smokebad0307/amb82-person-height-estimation/README_量測精度與問題分析.md

# AMB82 身高量測：目前公式、精度限制與問題排查

更新日期：2026-10-15。供組員理解目前結果，以及規劃「相機 bbox＋超聲波測距」的下一輪實驗。

## 目前的判斷

**影像高度加上距離，在適當的相機幾何與量測條件下，可以估算身高。但目前四位受試者得到的公式，尚未達到未知人物身高誤差 ±2 cm 的目標。**

目前使用複核過的影像端點及照片標示距離，留一受試者驗證的身高 RMSE 已約 3.93 cm，最大絕對誤差約 9.66 cm。未來接上自動 bbox 與超聲波後，還需要驗證這兩個輸入帶來的額外誤差。

更換較好的測距模組可能改善波動，但不能自行消除「測距終點不同」、相機設定、人體姿勢或 bbox 邊界的偏差。**目前的 3.93 cm 也不是這種方法無法改善的理論下限。**

## 1. 我們要做的系統

目標流程：

1. AMB82 相機拍攝人物，取得全身 bbox。
2. 將 bbox 座標還原到校正使用的影像座標，計算像素高度 `h`。
3. 超聲波取得距離讀值，確認其量測基準並換算成公式需要的距離 `D`。
4. 將 `h` 與 `D` 代入公式，得到身高估計 `H_est`。
5. 使用未參與校正的人與拍攝批次，驗證整套系統是否達到 ±2 cm。

### 使用者已確認的條件

| 項目 | 目前條件 |
|---|---|
| 精度目標 | 身高誤差在 ±2 cm 以內 |
| 相機 | AMB82-mini；本次原圖為 1280×720 |
| 距離定義 | 鏡頭與人體中心各自垂直投影到地面後，兩個投影點之間的水平距離 |
| 拍攝條件 | 四組拍攝時，相機位置、俯仰角與影像設定「大致固定」；尚無精確固定程度的量測紀錄 |
| 超聲波 | 目前使用 HC-SR04，使用者反映效果不好，預計更換模組 |
| 身高基準 | 四位受試者的參考身高皆包含拍照時的鞋子 |

**本文件沒有 HC-SR04 的實測誤差紀錄，不能將現有身高偏差直接歸因於該模組。** 目前離線資料使用的是照片標示距離，尚未完成實際超聲波讀值與身高結果的整合驗證。

## 2. 距離與像素高度的定義

### 距離 D 是地面上的水平距離

以下為側面示意；C 與 P 的高度不必相同：

```text
鏡頭 C                    人體中心 P
     |                             |
     | 垂直投影                    | 垂直投影
     |                             |
地面 A --------------------------- B
                 水平距離 D
```

兩條投影線都垂直地面且互相平行，`D = A 到 B 的水平距離`。相機光軸與超聲波軸線是否水平，需要另外記錄，不能只由這個距離定義判定。

在相機光軸水平、人物站直、頭腳近似位於相同深度，且人物位於相機正前方的條件下，這個水平距離可近似作為成像模型所需的深度。若人偏向側方，地面兩點的直線距離與沿光軸的深度也要區分。

### 像素高度 h 的定義

- 校正使用原始 1280×720 影像。
- 端點為可辨識的頭髮頂端與最低鞋底，排除地面陰影。
- 本次標註座標從 0 起算，兩端像素都包含：`h = y_max - y_min + 1`。
- 若部署程式使用浮點座標或右下角不包含的 bbox，應依該格式計算並統一量測定義，不可直接混用 `+1`。
- 這是影像中的垂直跨度；髮型、站姿與鞋子都會影響它。

## 3. 目前公式與資料範圍

主要公式直接擬合每張照片的 `cm/px`：

```text
s(D) = 0.001374586854 × D + 0.022063368530
H_est = h × s(D)

D：水平距離，cm
h：影像全身高度，px
s：影像比例，cm/px
H_est：估計含鞋身高，cm
```

| 受試者 | 含鞋身高 | 照片數 | 納入統計 |
|---|---:|---:|---:|
| lai | 162 cm | 40 | 40 |
| yang | 170 cm | 45 | 45 |
| wang | 173 cm | 20 | 19 |
| huang | 188 cm | 41 | 41 |
| 合計 | — | 146 | 145 |

實測距離為 180、190、200、220、240、250、260、300 cm；190、250 cm 只有原 wang 資料。`173_wang/190_5.jpg` 因頭頂疑似裁切，保留可見高度但排除擬合。

目前沒有對其他身高範圍、任意場景或任意相機姿態的精度保證。每 1 cm 預測表是公式計算結果，不代表每個距離都拍過照片。

另有像素目標反比模型 `H_est = h × D / 676.873420513`，它與上面的主要公式使用不同擬合目標，不能混用係數。本文件的誤差敏感度與 ±2 cm 達成比例，均以主要直線公式為準。

## 4. 現有資料能支持多少精度

| 評估方式 | 身高誤差 | 代表的意義 |
|---|---:|---|
| 全資料擬合，再評估原資料 | RMSE 3.205 cm | 公式對已看過資料的擬合程度 |
| 留一距離驗證 | RMSE 3.341 cm | 保留一個距離，用其他距離擬合後預測 |
| 留一受試者驗證 | RMSE 3.925 cm | 保留一人的全部照片，用另外三人擬合後預測 |
| 留一受試者最大絕對誤差 | 9.656 cm | 本批驗證中最差的單張結果 |
| 留一受試者誤差在 ±2 cm 內 | 71／145 張，約 49.0% | 本批照片的達標比例 |

留一受試者更接近「遇到未知身高的人」的使用情境，但目前只有四位受試者，且人員與拍攝批次混雜。145 張照片不等於 145 位獨立受試者，49.0% 也不能當作未來部署的成功率。

**RMSE 是誤差大小的統計指標，不是最大誤差界限。** RMSE 3.925 cm 不代表每次都在 ±3.925 cm 內。

比例擬合的 R² 約為 0.988，仍不代表身高能準到 ±2 cm；距離變化造成的整體趨勢可以很明顯，同時保留數公分的系統偏差。

目前的擬合身高誤差與分組驗證

## 5. 可能造成大偏差的四個環節

### 5.1 超聲波量測終點與原公式不一致

原校正 `D` 的終點是人體中心的地面投影。超聲波的回波則可能來自胸口、腹部、衣服或其他可被偵測的表面，並不是人體中心。模組與鏡頭本身也可能有前後或左右的安裝偏移。

即使測距方向與地面平行，這個終點差異仍然存在：兩個讀值都可能很穩定，但有固定偏差。人體厚度、姿勢及衣服不同，偏差也可能改變，因此不能預設加一個固定常數就能解決所有人。

超聲波對回波的選擇依模組而異；例如 MaxBotix 的部分模組以首個足夠強的回波決定距離，常對應視野內較近的可偵測物體。這是需實測確認的測距行為，不能直接套成 HC-SR04 的實測規格。[廠商說明](https://maxbotix.com/blogs/blog/best-ultrasonic-sensor-indoor-mobile-robotics)

**要做的事：** 同時記錄已知水平距離、原始超聲波讀值、模組安裝位置及人體姿態，先確認兩個距離的關係。若改用超聲波原始讀值作為新模型輸入，必須重新校正，並驗證不同體型與新受試者。

### 5.2 現有資料已有批次差異

同樣標示 200 cm，各組平均像素高度除以各自參考身高後：

| 受試者 | 平均像素高度 | 參考身高 | 平均像素／身高 |
|---|---:|---:|---:|
| lai | 554.29 px | 162 cm | 3.422 px/cm |
| yang | 566.00 px | 170 cm | 3.329 px/cm |
| wang | 604.80 px | 173 cm | 3.496 px/cm |
| huang | 626.50 px | 188 cm | 3.332 px/cm |

wang 與 yang 的比例相差約 5%。同一人同距離的照片卻通常只有約 1–2 px 的波動，表示**重複量測穩定，不等於不同批次的絕對比例一致**。

可能原因包含距離基準、站位、相機角度、影像設定、姿勢或參考身高，現有資料不足以確定主因。合併直線只能折衷這些差異。

原 wang 批次在合併公式下平均高估約 6.32 cm；lai 的 180 cm 組也有較大負偏差。這些資料已保留，不能因為誤差大就直接刪除。增加高次項也尚未改善問題：二次式的留一受試者 RMSE 約 4.02 cm，直線約 3.93 cm。

**要做的事：** 在同一次固定架設下，讓四人輪流站到同一個精確位置，重新比較比例。每次離開再站回，才能觀察站位重現性；不要只用連拍代替獨立重站。

### 5.3 相機幾何及影像設定不完全相同

在理想、水平、已處理畸變的成像條件下，可近似寫成：

```text
h ≈ f_y × H / D
```

其中 `f_y` 是以像素為單位的垂直焦距。這說明方案理論上可行，但需要幾何條件成立；目前由資料擬合出的係數，不等於已完成相機內參標定。

相機俯仰時，頭頂與腳底在相機座標中的深度可能不同，影像比例會受相機姿態、人物身高及位置影響。鏡頭畸變、裁切、解析度與縮放也會改變對應關係。[OpenCV 相機投影與校正模型](https://docs.opencv.org/4.13.0/d9/d0c/group__calib3d.html)

**要做的事：** 固定支架、相機位置、俯仰與滾轉角，記錄相機高度與影像設定。需要時使用標定板取得內參與畸變參數。推論圖若經 resize 或 letterbox，必須先將 bbox 正確還原到校正座標。

### 5.4 自動 bbox 與目前複核端點的定義不同

目前資料是逐張檢視後的頭腳端點，不是部署中的自動人體偵測器輸出，也不是獨立人工真值驗證。偵測器可能框得較鬆、漏掉髮束或鞋底，或隨影像跳動。

人物偵測信心分數高，不代表上下界適合精準量身高。頭腳裁切、遮擋、彎膝、身體傾斜、髮型與鞋子，也會影響影像垂直高度與參考身高的對應。

**要做的事：** 在相同影像上比較實際偵測器 bbox 與複核端點，分別記錄頭頂、鞋底及總高度誤差。髮頂和鞋底仍須與參考身高的量測定義對齊。先以站直、頭腳完整可見的人驗證。

## 6. 為什麼幾公分的測距偏差就會超標

從主要公式 `H_est = h(aD+b)` 可得到小誤差的一階近似：

```text
ΔH ≈ (aD+b) × Δh + a×h × ΔD
```

以下假設約 170 cm 的人符合目前公式，位於 200 cm 處，影像高度約 572.4 px：

```text
ΔH ≈ 0.297 × Δh + 0.787 × ΔD

ΔH：cm；Δh：px；ΔD：cm
```

| 單一輸入偏差，其餘保持相同 | 推估身高變化的絕對值 |
|---|---:|
| 距離差 1 cm | 約 0.79 cm |
| 距離差 5 cm | 約 3.93 cm |
| 距離差 10 cm | 約 7.87 cm |
| bbox 高度差 5 px | 約 1.48 cm |
| bbox 高度差 10 px | 約 2.97 cm |

示意：人體中心水平距離若為 200 cm，超聲波卻量到前方表面 190 cm，直接把 190 代入目前公式，身高會少算約 7.9 cm。**這是敏感度示例，不是目前已實測到的 10 cm 偏移。**

同樣以這個 200 cm 案例來看，若其他誤差完全為零，要把身高誤差限制在 2 cm，單獨的距離誤差需小於約 2.54 cm，或單獨的 bbox 高度誤差需小於約 6.73 px。實際上兩者都會有誤差，還有模型偏差，因此可分配給每一項的範圍更小。

例如 bbox 高度誤差 3 px、距離誤差 1 cm，若同方向影響，身高變化已約 1.68 cm，剩給其他誤差的空間很少。到 300 cm，10 px 的高度偏差會變成約 4.34 cm。

這些數字描述輸入偏差的影響，不是模組規格或整套系統的保證誤差，也不能直接與現有 RMSE 相加當作總誤差。

## 7. 下一輪實驗：分開找出誤差來源

| 步驟 | 使用的輸入 | 要回答的問題 |
|---|---|---|
| A | 複核端點＋精準水平距離 | 固定條件下，相機幾何與公式本身能否達到目標？ |
| B | 自動 bbox＋與 A 相同的精準水平距離 | 自動框額外增加多少誤差？ |
| C | 複核端點＋經基準對齊的超聲波距離 | 測距額外增加多少誤差？ |
| D | 自動 bbox＋超聲波，使用未參與校正的人與批次 | 整套系統是否達到 ±2 cm？ |

建議執行順序：

1. **先固定架設與站位。** 以一個距離（例如 200 cm）開始，四人輪流量測，檢查約 5% 的比例差異是否仍存在。
2. **同步記錄兩種距離。** 保留精準水平距離與超聲波原始讀值，確認終點、安裝偏移及不同體型造成的差異。保留影像與距離時間戳，避免人移動時配到不同時刻的讀值。
3. **比較自動與複核端點。** 使用同一張原圖、同一套座標，記錄上下界各自的偏差。
4. **擴展到不同距離與重新站位。** 在 180–300 cm 範圍內重做，區分組內抖動與重新站位造成的差異。
5. **用獨立資料驗收。** 加入新受試者及重新架設／不同日期的資料。先固定模型，再測試，不能用測試結果反覆調參後仍稱為獨立驗證。

建議每次保留：受試者與含鞋參考身高、原圖、bbox 與座標格式、複核端點、水平距離、超聲波原始讀值、時間戳、相機設定、站位／姿勢及有效或失敗原因。

驗收至少同時報告平均偏差、MAE、RMSE、最大絕對誤差、±2 cm 內比例，以及無法量測的比例。**不能只用「RMSE 小於 2 cm」代替「每次誤差都在 ±2 cm」。** 團隊也應先定義目標是每次有效量測都達標，還是在指定條件下達到約定的成功比例。

## 8. 組員閱讀入口與資料依據

- [專案主 README](README.md)：專案架構與重建流程。
- [四人合併分析報告](outputs/amb82_height_multi/分析報告.md)：完整統計、各模型及驗證結果。
- [受試者與距離分組統計](outputs/amb82_height_multi/subject_distance_summary.csv)：200 cm 組等數值的來源。
- [完整結果 JSON](outputs/amb82_height_multi/results.json)：逐張量測、模型係數與各折驗證參數。
- [Excel 統計與換算器](outputs/amb82_height_multi/AMB82_四人身高校正.xlsx)：方便查閱與代入計算。
- [最終複核標註](analysis/multi_subject/reviewed_annotations.json)：目前離線量測來源。

本文件的 71／145 張達標比例，由 JSON 中直線模型的留一受試者各折係數，對各自保留的有效照片重新計算 `abs(H_est - H) <= 2` 得到。誤差敏感度則由目前合併公式直接計算。文中列出的可能原因是待驗證假設，不表示已找出確定主因。
